Iva0108/STM32-PCB/3d view.png

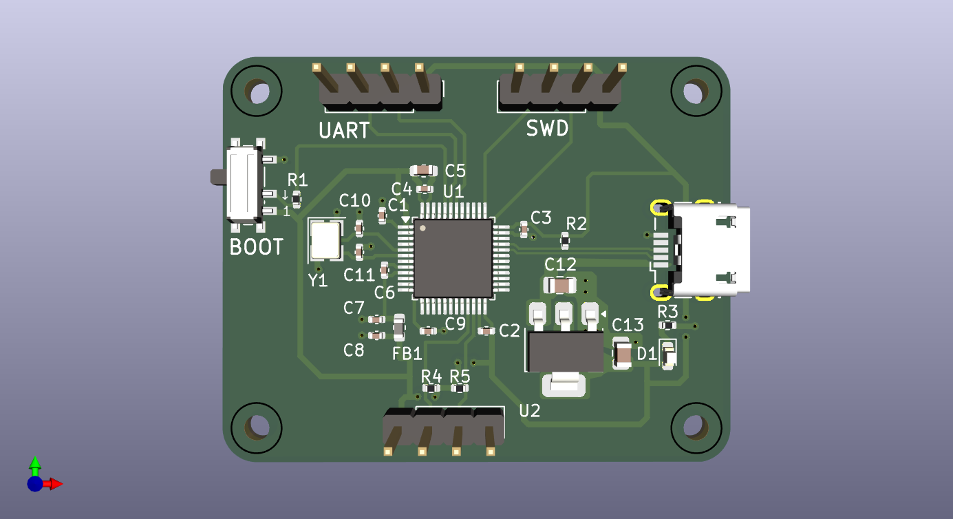
3d view.png
