Iva0108/STM32-PCB/README.md

# STM32-PCB
STM32 PCB designed in KiCad 9.0
