Iva0108/STM32-PCB/kurs.kicad_pcb

## KiCad design kurs.kicad_pcb (2025-05-19)

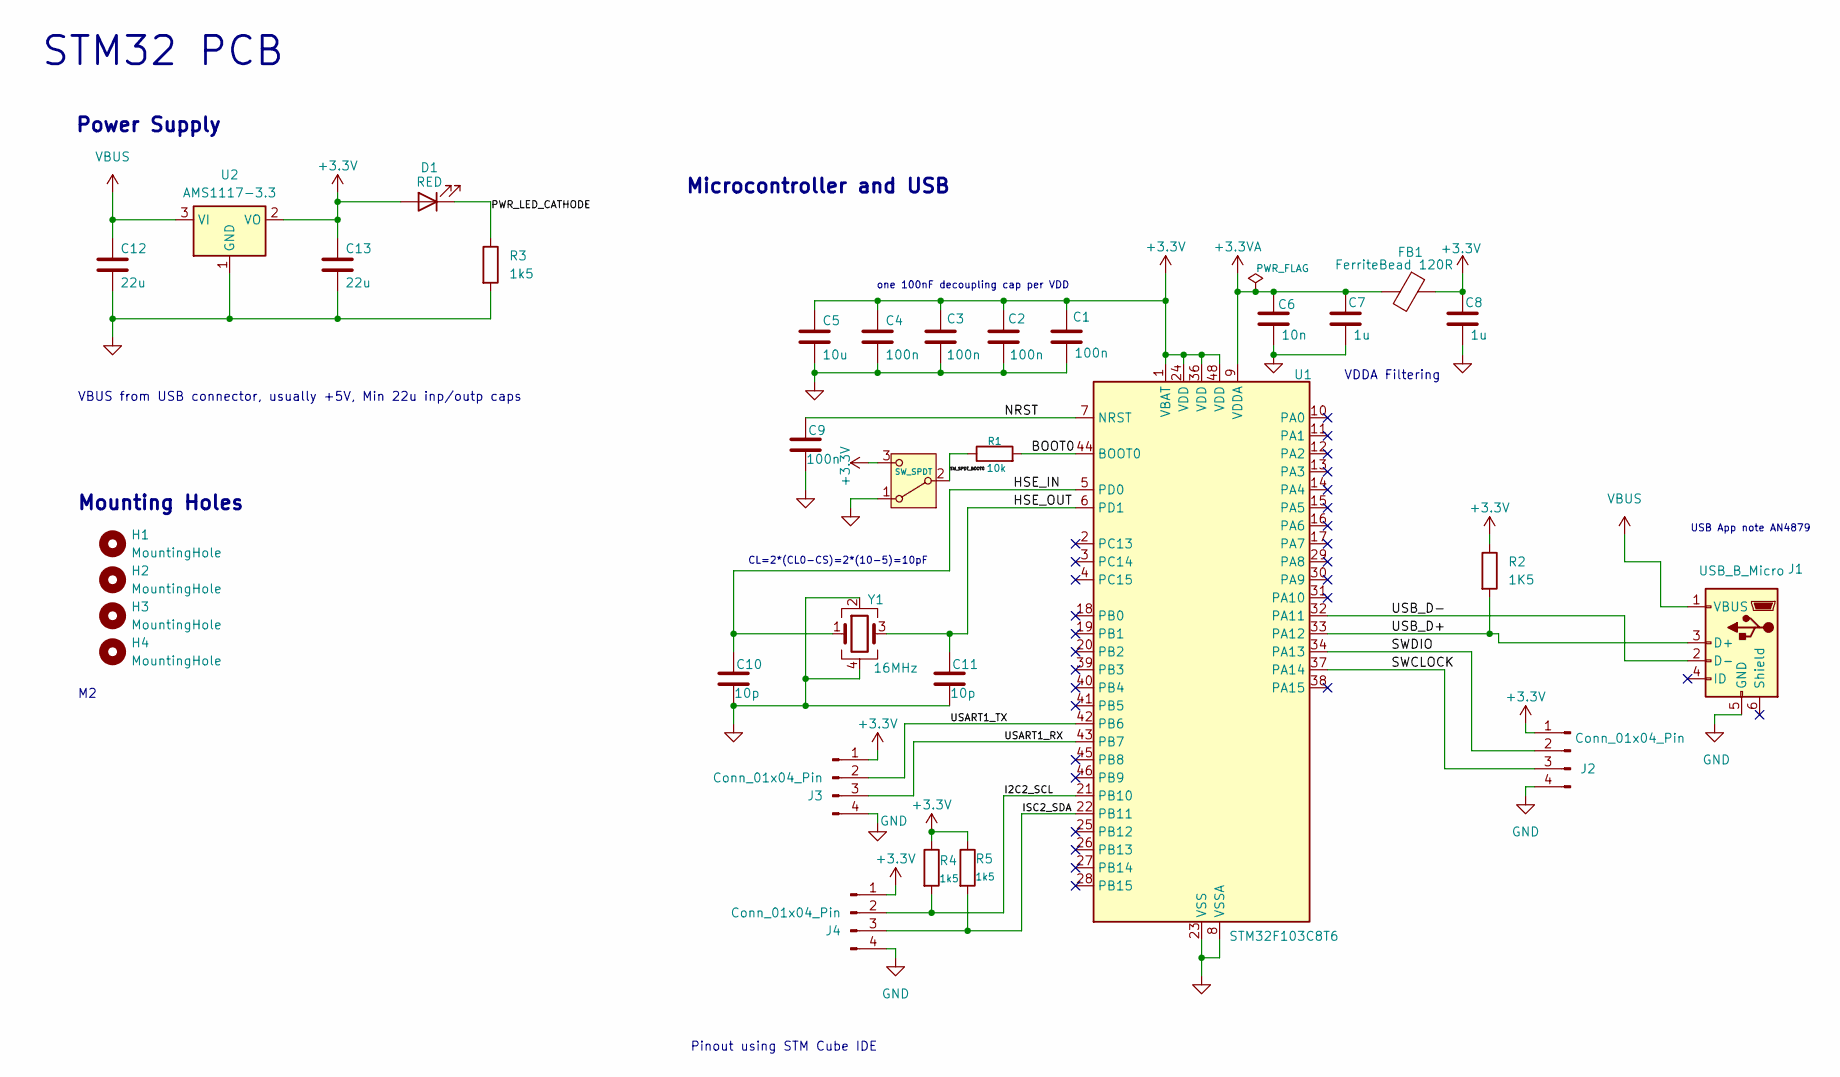
[picture p3: schematic kurs.kicad_sch, STM32 PCB]

Parts:
C1, C2, C3, C4, C9: 100n; C_0402_1005Metric
C5: 10u; C_0603_1608Metric
C6: 10n; C_0402_1005Metric
C7, C8: 1u; C_0402_1005Metric
C10, C11: 10p; C_0402_1005Metric
C12, C13: 22u; C_0805_2012Metric
D1: RED; LED_0603_1608Metric
FB1: FerriteBead 120R; L_0603_1608Metric
H1, H2, H3, H4: MountingHole; MountingHole_2.2mm_M2
J1: USB_B_Micro; USB_Micro-B_Wuerth_629105150521
J2, J3, J4: Conn_01x04_Pin; PinHeader_1x04_P2.54mm_Vertical
R1: 10k; R_0402_1005Metric
R2: 1K5; R_0402_1005Metric
R3, R4, R5: 1k5; R_0402_1005Metric
SW1: SW_SPDT; SW_SPDT_PCM12_NOSILK
U1: STM32F103C8T6; LQFP-48_7x7mm_P0.5mm
U2: AMS1117-3.3; SOT-223-3_TabPin2
Y1: 16MHz; Crystal_SMD_3225-4Pin_3.2x2.5mm

Connections:
+3.3V: C1.1, C2.1, C3.1, C4.1, C5.1, C8.1, C13.1, D1.2 (A), FB1.1, J2.1, J3.1, J4.1, R2.1, R4.1, R5.1, SW1.3 (C), U1.1 (VBAT), U1.24 (VDD), U1.36 (VDD), U1.48 (VDD), U2.2 (VO)
+3.3VA: C6.1, C7.1, FB1.2, U1.9 (VDDA)
/BOOT0: R1.2, U1.44 (BOOT0)
/HSE_IN: C10.1, U1.5 (PD0), Y1.1
/HSE_OUT: C11.1, U1.6 (PD1), Y1.3
/I2C2_SCL: J4.2, R4.2, U1.21 (PB10)
/ISC2_SDA: J4.3, R5.2, U1.22 (PB11)
/NRST: C9.1, U1.7 (NRST)
/PWR_LED_CATHODE: D1.1 (K), R3.1
/SWCLOCK: J2.3, U1.37 (PA14)
/SWDIO: J2.2, U1.34 (PA13)
/SW_SPDT_BOOT0: R1.1, SW1.2 (B)
/USART1_RX: J3.3, U1.43 (PB7)
/USART1_TX: J3.2, U1.42 (PB6)
/USB_D+: J1.3 (D+), R2.2, U1.33 (PA12)
/USB_D-: J1.2 (D-), U1.32 (PA11)
GND: C1.2, C2.2, C3.2, C4.2, C5.2, C6.2, C7.2, C8.2, C9.2, C10.2, C11.2, C12.2, C13.2, J1.5 (GND), J2.4, J3.4, J4.4, R3.2, SW1.1 (A), U1.8 (VSSA), U1.23 (VSS), U1.35 (VSS), U1.47 (VSS), U2.1 (GND), Y1.2, Y1.4
VBUS: C12.1, J1.1 (VBUS), U2.3 (VI)

Notes on the sheet:
CL=2*(CL0-CS)=2*(10-5)=10pF
Power Supply
VDDA Filtering
Pinout using STM Cube IDE
Microcontroller and USB
Mounting Holes
one 100nF decoupling cap per VDD
STM32 PCB
VBUS from USB connector, usually +5V, Min 22u inp/outp caps
USB App note AN4879

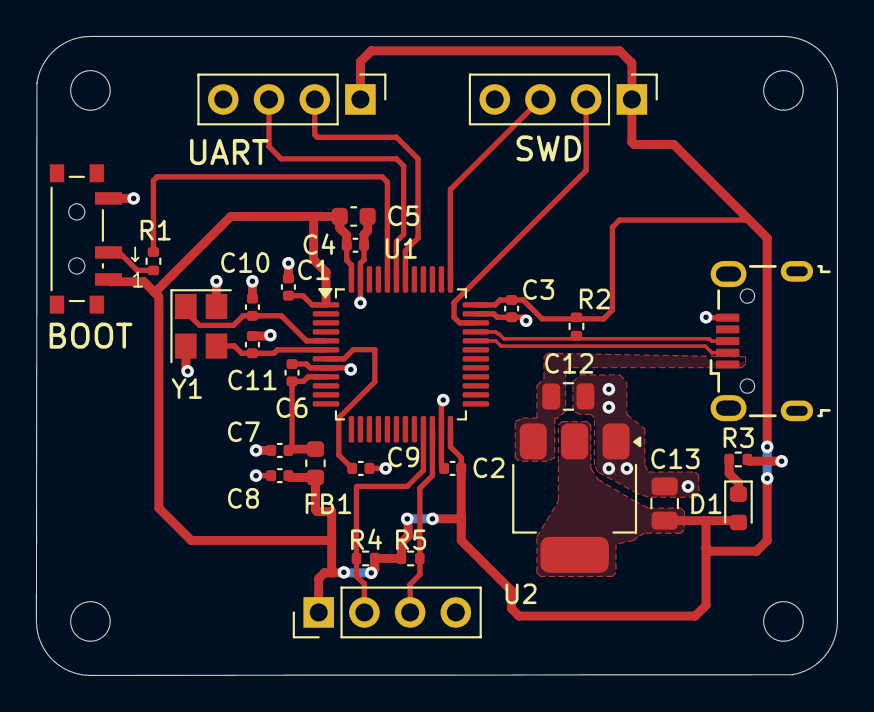
[picture p4: board kurs.kicad_pcb from above]

Board: 2 copper layers, 44.5 x 35.5 mm, 32 parts (0 on the bottom side), 18 nets.
